GuavTek/beat_sequencer/README.md

A MIDI sequencer for percussion using a RP-PICO, WS2812 LEDs, and cherry style keyboard switches
