GuavTek/beat_sequencer/models/Brackets.FCStd

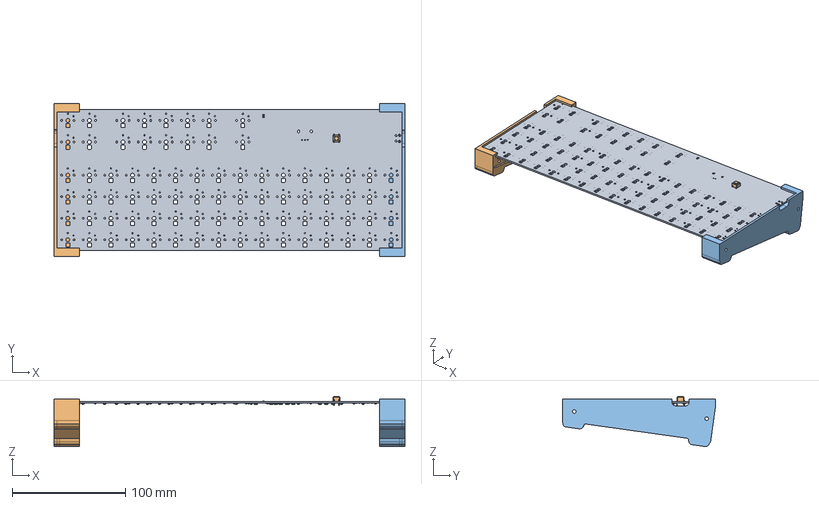
[picture p1: CAD file, 2025-08-24]
models/Brackets.FCStd
309.4 x 134.6 x 44.2 mm
Pcb_fe1a
SW1_SW_PUSH_6mm_1e4c37d32693
R12_R_0603_1608Metric_42a85f441d96
R11_R_0603_1608Metric_2ad46005715d
D87_D_SOD-323_df57b024e58b
C54_C_0603_1608Metric_0bb739a3cacc
D88_D_SOD-323_5da01f37f255
R5_R_0603_1608Metric_38cea7d3a2cd
C58_C_0603_1608Metric_b7960c42b45d
C64_C_0603_1608Metric_9a160810e8e0
C68_C_0603_1608Metric_f0870da7f894
C20_C_0603_1608Metric_39ede622b60a
D93_D_SOD-323_66f03b6b84d4
C74_C_0603_1608Metric_994731c39234
D102_D_SOD-323_32bd23d8ab15
D91_D_SOD-323_a9d0ef1906f3
C62_C_0603_1608Metric_5dbc99736f9b
D126_D_SOD-323_1330ebb01137
D135_D_SOD-323_9d37f7f3c965
C37_C_0603_1608Metric_5208c6173dee
C3_C_0603_1608Metric_93aa2dda32cd
C40_C_0603_1608Metric_ccfb9d428a65
C73_C_0603_1608Metric_03d7558e01c5
D97_D_SOD-323_eaafedaa016f
R14_R_0603_1608Metric_2a0c1422eca9
D145_D_SOD-323_bd2c4b9b8c90
Q1_SOT-23_5640edacd0cb
D120_D_SOD-323_66820572dc02
C52_C_0603_1608Metric_7ae5c74cfe28
C11_C_0603_1608Metric_020c473892fd
C32_C_0603_1608Metric_78320fb544b5
C78_C_0603_1608Metric_072a739cbfb6
C47_C_0603_1608Metric_d000b179ed23
D95_D_SOD-323_79b8c3906511
C43_C_0603_1608Metric_1a32d7d28331
C38_C_0603_1608Metric_9d6507d8d500
D81_D_SOD-323_9596605a0159
D114_D_SOD-323_caa570405683
C9_C_0603_1608Metric_98b8517860d0
C65_C_0603_1608Metric_bca26b5c2557
C60_C_0603_1608Metric_b23a9420f492
D156_D_SOD-323_725008c5ad5e
C44_C_0603_1608Metric_2969dd3a299a
C29_C_0603_1608Metric_ec4414a6af9b
C19_C_0603_1608Metric_21f14bfd3467
Q4_SOT-23_cc986ddf7d09
D105_D_SOD-323_dec81850e9a2
D146_D_SOD-323_f9cb06448b9b
D125_D_SOD-323_48fd01ee04ac
R7_R_0603_1608Metric_6d629bdbb133
C80_C_0603_1608Metric_6dd7261405f1
Q6_SOT-23_9162bb17def2
D132_D_SOD-323_067e024d3ad2
D117_D_SOD-323_39e64060aef6
D106_D_SOD-323_b2b98c925441
D84_D_SOD-323_7ff9f476dcc5
D113_D_SOD-323_2862c8264082
D116_D_SOD-323_dfc335532dbf
C2_C_0603_1608Metric_1f6ee4a5b66e
D134_D_SOD-323_ed6a9de8ff42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
