GuavTek/beat_sequencer/models/Brackets-Left bracket.stl

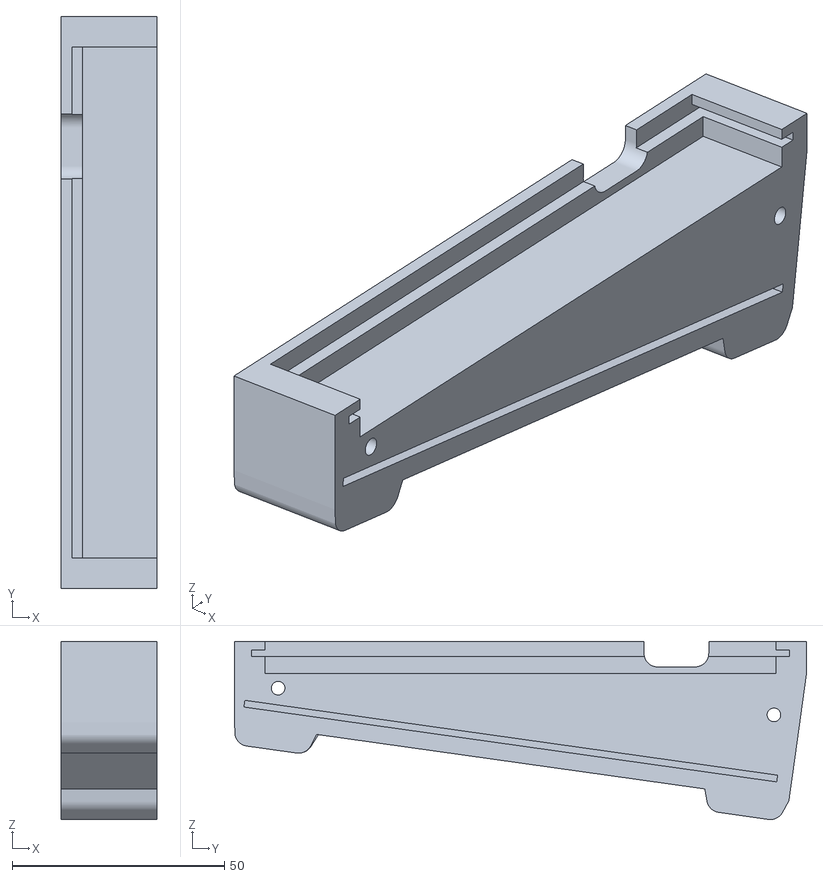
[picture p2: CAD file, 2025-08-24]
models/Brackets-Left bracket.stl
22.5 x 134.6 x 41.9
