GuavTek/beat_sequencer/models/Brackets-Left bracket (mirrored).stl

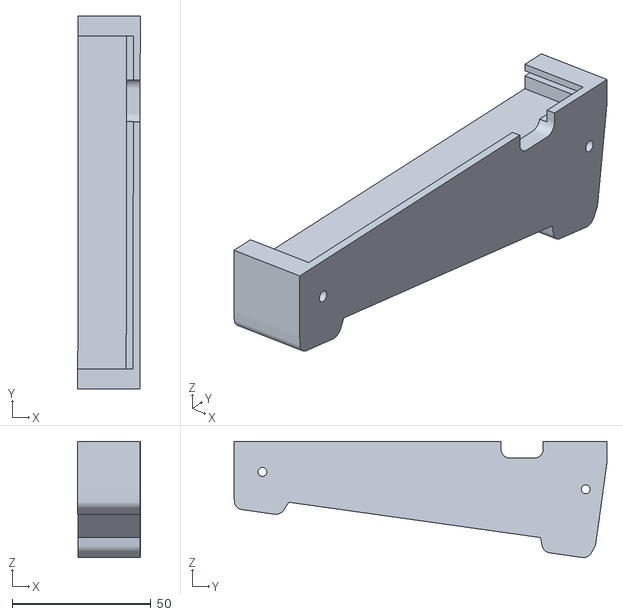
[picture p3: CAD file, 2025-08-24]
models/Brackets-Left bracket (mirrored).stl
22.6 x 134.6 x 41.9
