GuavTek/beat_sequencer/hardware_mx/beat_sequencer.kicad_pcb

## KiCad design hardware_mx/beat_sequencer.kicad_pcb (2025-08-23)

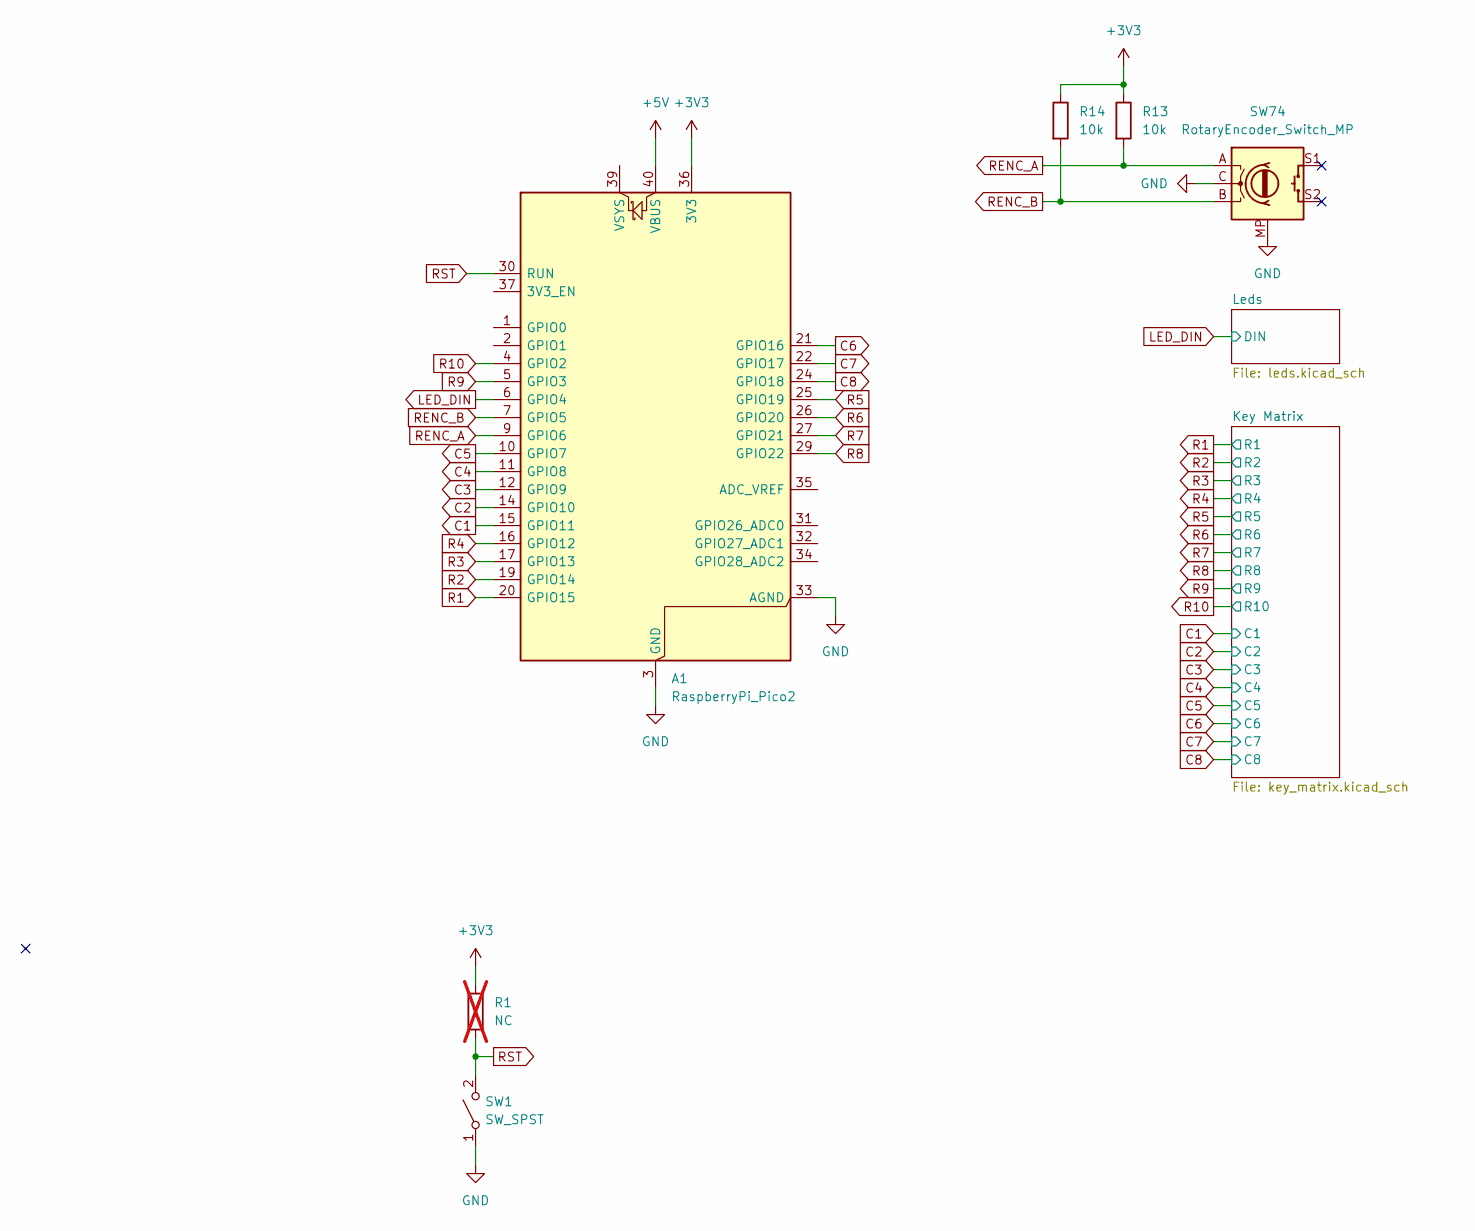
[picture p4: schematic beat_sequencer.kicad_sch]

Parts:
A1: RaspberryPi_Pico2; RaspberryPi_Pico_Common_SMD
R1: NC; R_0603_1608Metric; not fitted
R13, R14: 10k; R_0603_1608Metric
SW1: SW_SPST; SW_PUSH_6mm
SW74: RotaryEncoder_Switch_MP; RotaryEncoder_Alps_EC12E_Vertical_H20mm

Connections:
+3V3: A1.36 (3V3), R1.1, R13.1, R14.1; also elsewhere on the board
+5V: A1.40 (VBUS); also elsewhere on the board
C1: A1.15 (GPIO11); also elsewhere on the board
C2: A1.14 (GPIO10); also elsewhere on the board
C3: A1.12 (GPIO9); also elsewhere on the board
C4: A1.11 (GPIO8); also elsewhere on the board
C5: A1.10 (GPIO7); also elsewhere on the board
C6: A1.21 (GPIO16); also elsewhere on the board
C7: A1.22 (GPIO17); also elsewhere on the board
C8: A1.24 (GPIO18); also elsewhere on the board
GND: A1.3 (GND), A1.8 (GND), A1.13 (GND), A1.18 (GND), A1.23 (GND), A1.28 (GND), A1.33 (AGND), A1.38 (GND), SW1.1 (A), SW74.C, SW74.MP; also elsewhere on the board
LED_DIN: A1.6 (GPIO4); also elsewhere on the board
R1: A1.20 (GPIO15); also elsewhere on the board
R2: A1.19 (GPIO14); also elsewhere on the board
R3: A1.17 (GPIO13); also elsewhere on the board
R4: A1.16 (GPIO12); also elsewhere on the board
R5: A1.25 (GPIO19); also elsewhere on the board
R6: A1.26 (GPIO20); also elsewhere on the board
R7: A1.27 (GPIO21); also elsewhere on the board
R8: A1.29 (GPIO22); also elsewhere on the board
R9: A1.5 (GPIO3); also elsewhere on the board
R10: A1.4 (GPIO2); also elsewhere on the board
RENC_A: A1.9 (GPIO6), R13.2, SW74.A
RENC_B: A1.7 (GPIO5), R14.2, SW74.B
RST: A1.30 (RUN), R1.2, SW1.2 (B)

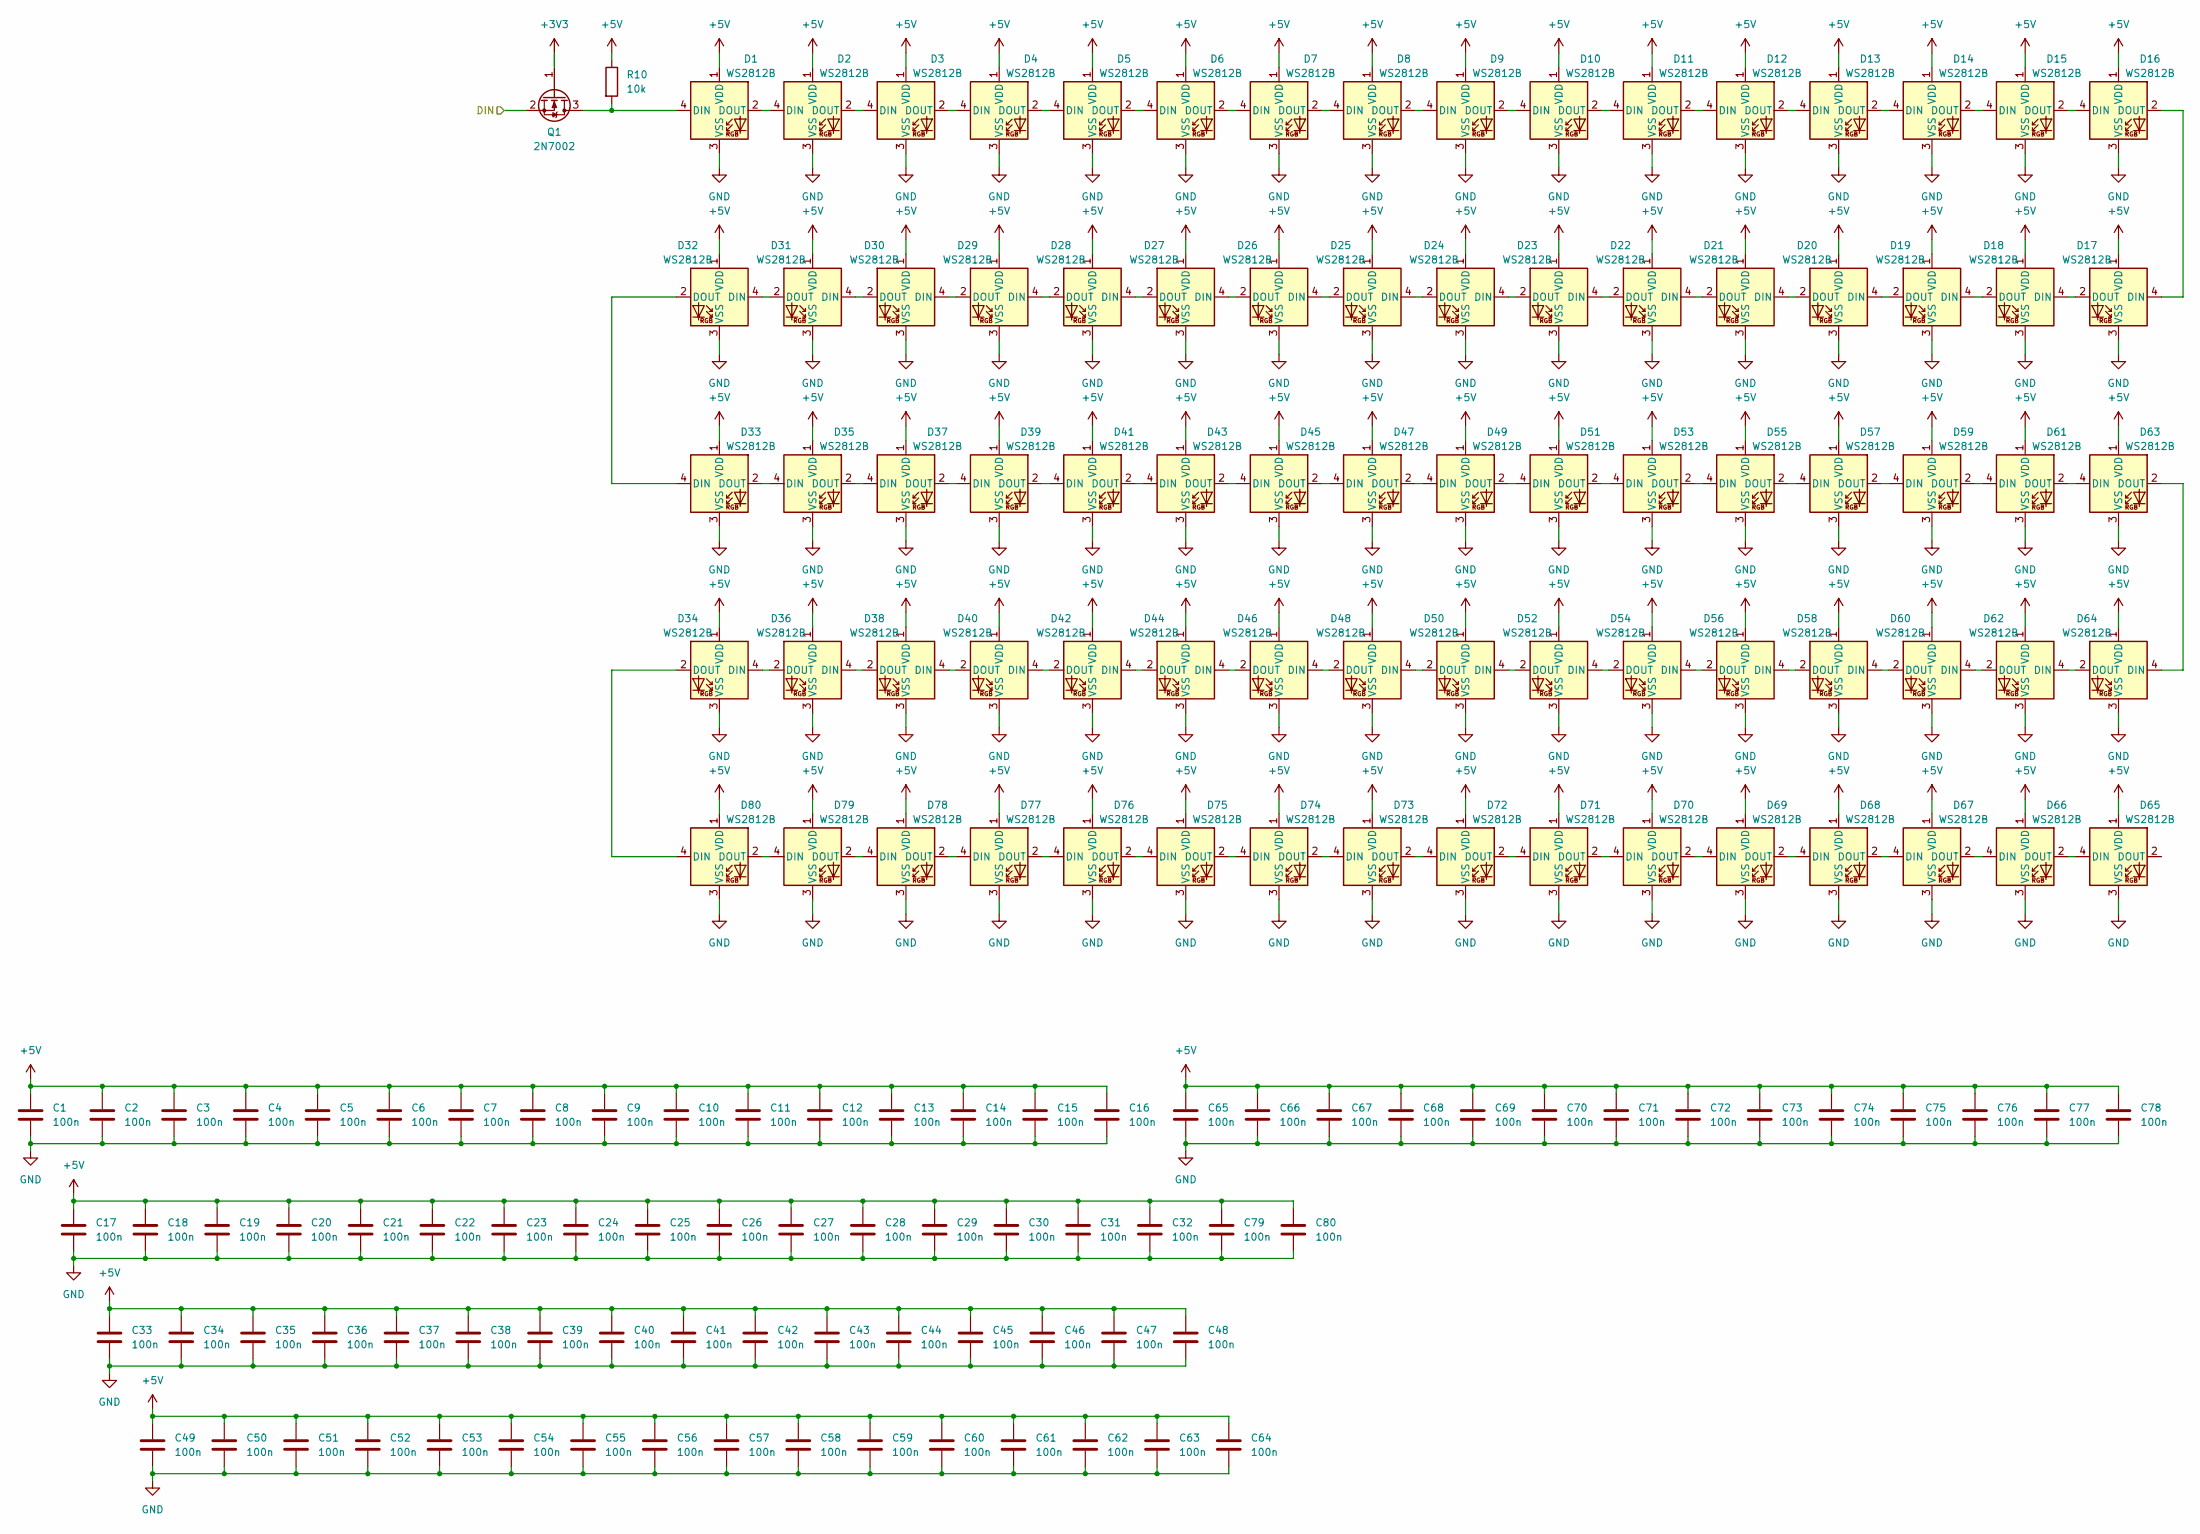
[picture p5: schematic leds.kicad_sch]

Parts:
C1, C2, C3, C4, C5, C6, C7, C8, C9, C10, C11, C12, C13, C14, C15, C16, C17, C18, C19, C20, C21, C22, C23, C24, C25, C26, C27, C28, C29, C30, C31, C32, C33, C34, C35, C36, C37, C38, C39, C40, C41, C42, C43, C44, C45, C46, C47, C48, C49, C50, C51, C52, C53, C54, C55, C56, C57, C58, C59, C60, C61, C62, C63, C64, C65, C66, C67, C68, C69, C70, C71, C72, C73, C74, C75, C76, C77, C78, C79, C80: 100n; C_0603_1608Metric
D1, D2, D3, D4, D5, D6, D7, D8, D9, D10, D11, D12, D13, D14, D15, D16, D17, D18, D19, D20, D21, D22, D23, D24, D25, D26, D27, D28, D29, D30, D31, D32, D33, D34, D35, D36, D37, D38, D39, D40, D41, D42, D43, D44, D45, D46, D47, D48, D49, D50, D51, D52, D53, D54, D55, D56, D57, D58, D59, D60, D61, D62, D63, D64, D65, D66, D67, D68, D69, D70, D71, D72, D73, D74, D75, D76, D77, D78, D79, D80: WS2812B; LED_SK6812_MINI_REVERSE
Q1: 2N7002; SOT-23
R10: 10k; R_0603_1608Metric

Connections:
+3V3: Q1.1 (G); also elsewhere on the board
+5V: C1.1, C2.1, C3.1, C4.1, C5.1, C6.1, C7.1, C8.1, C9.1, C10.1, C11.1, C12.1, C13.1, C14.1, C15.1, C16.1, C17.1, C18.1, C19.1, C20.1, C21.1, C22.1, C23.1, C24.1, C25.1, C26.1, C27.1, C28.1, C29.1, C30.1, C31.1, C32.1, C33.1, C34.1, C35.1, C36.1, C37.1, C38.1, C39.1, C40.1, C41.1, C42.1, C43.1, C44.1, C45.1, C46.1, C47.1, C48.1, C49.1, C50.1, C51.1, C52.1, C53.1, C54.1, C55.1, C56.1, C57.1, C58.1, C59.1, C60.1, C61.1, C62.1, C63.1, C64.1, C65.1, C66.1, C67.1, C68.1, C69.1, C70.1, C71.1, C72.1, C73.1, C74.1, C75.1, C76.1, C77.1, C78.1, C79.1, C80.1, D1.1 (VDD), D2.1 (VDD), D3.1 (VDD), D4.1 (VDD), D5.1 (VDD), D6.1 (VDD), D7.1 (VDD), D8.1 (VDD), D9.1 (VDD), D10.1 (VDD), D11.1 (VDD), D12.1 (VDD), D13.1 (VDD), D14.1 (VDD), D15.1 (VDD), D16.1 (VDD), D17.1 (VDD), D18.1 (VDD), D19.1 (VDD), D20.1 (VDD), D21.1 (VDD), D22.1 (VDD), D23.1 (VDD), D24.1 (VDD), D25.1 (VDD), D26.1 (VDD), D27.1 (VDD), D28.1 (VDD), D29.1 (VDD), D30.1 (VDD), D31.1 (VDD), D32.1 (VDD), D33.1 (VDD), D34.1 (VDD), D35.1 (VDD), D36.1 (VDD), D37.1 (VDD), D38.1 (VDD), D39.1 (VDD), D40.1 (VDD), D41.1 (VDD), D42.1 (VDD), D43.1 (VDD), D44.1 (VDD), D45.1 (VDD), D46.1 (VDD), D47.1 (VDD), D48.1 (VDD), D49.1 (VDD), D50.1 (VDD), D51.1 (VDD), D52.1 (VDD), D53.1 (VDD), D54.1 (VDD), D55.1 (VDD), D56.1 (VDD), D57.1 (VDD), D58.1 (VDD), D59.1 (VDD), D60.1 (VDD), D61.1 (VDD), D62.1 (VDD), D63.1 (VDD), D64.1 (VDD), D65.1 (VDD), D66.1 (VDD), D67.1 (VDD), D68.1 (VDD), D69.1 (VDD), D70.1 (VDD), D71.1 (VDD), D72.1 (VDD), D73.1 (VDD), D74.1 (VDD), D75.1 (VDD), D76.1 (VDD), D77.1 (VDD), D78.1 (VDD), D79.1 (VDD), D80.1 (VDD), R10.1; also elsewhere on the board
GND: C1.2, C2.2, C3.2, C4.2, C5.2, C6.2, C7.2, C8.2, C9.2, C10.2, C11.2, C12.2, C13.2, C14.2, C15.2, C16.2, C17.2, C18.2, C19.2, C20.2, C21.2, C22.2, C23.2, C24.2, C25.2, C26.2, C27.2, C28.2, C29.2, C30.2, C31.2, C32.2, C33.2, C34.2, C35.2, C36.2, C37.2, C38.2, C39.2, C40.2, C41.2, C42.2, C43.2, C44.2, C45.2, C46.2, C47.2, C48.2, C49.2, C50.2, C51.2, C52.2, C53.2, C54.2, C55.2, C56.2, C57.2, C58.2, C59.2, C60.2, C61.2, C62.2, C63.2, C64.2, C65.2, C66.2, C67.2, C68.2, C69.2, C70.2, C71.2, C72.2, C73.2, C74.2, C75.2, C76.2, C77.2, C78.2, C79.2, C80.2, D1.3 (VSS), D2.3 (VSS), D3.3 (VSS), D4.3 (VSS), D5.3 (VSS), D6.3 (VSS), D7.3 (VSS), D8.3 (VSS), D9.3 (VSS), D10.3 (VSS), D11.3 (VSS), D12.3 (VSS), D13.3 (VSS), D14.3 (VSS), D15.3 (VSS), D16.3 (VSS), D17.3 (VSS), D18.3 (VSS), D19.3 (VSS), D20.3 (VSS), D21.3 (VSS), D22.3 (VSS), D23.3 (VSS), D24.3 (VSS), D25.3 (VSS), D26.3 (VSS), D27.3 (VSS), D28.3 (VSS), D29.3 (VSS), D30.3 (VSS), D31.3 (VSS), D32.3 (VSS), D33.3 (VSS), D34.3 (VSS), D35.3 (VSS), D36.3 (VSS), D37.3 (VSS), D38.3 (VSS), D39.3 (VSS), D40.3 (VSS), D41.3 (VSS), D42.3 (VSS), D43.3 (VSS), D44.3 (VSS), D45.3 (VSS), D46.3 (VSS), D47.3 (VSS), D48.3 (VSS), D49.3 (VSS), D50.3 (VSS), D51.3 (VSS), D52.3 (VSS), D53.3 (VSS), D54.3 (VSS), D55.3 (VSS), D56.3 (VSS), D57.3 (VSS), D58.3 (VSS), D59.3 (VSS), D60.3 (VSS), D61.3 (VSS), D62.3 (VSS), D63.3 (VSS), D64.3 (VSS), D65.3 (VSS), D66.3 (VSS), D67.3 (VSS), D68.3 (VSS), D69.3 (VSS), D70.3 (VSS), D71.3 (VSS), D72.3 (VSS), D73.3 (VSS), D74.3 (VSS), D75.3 (VSS), D76.3 (VSS), D77.3 (VSS), D78.3 (VSS), D79.3 (VSS), D80.3 (VSS); also elsewhere on the board
LED_DIN: Q1.2 (S); also elsewhere on the board
unnamed: D1.4 (DIN), Q1.3 (D), R10.2
unnamed: D1.2 (DOUT), D2.4 (DIN)
unnamed: D2.2 (DOUT), D3.4 (DIN)
unnamed: D3.2 (DOUT), D4.4 (DIN)
unnamed: D4.2 (DOUT), D5.4 (DIN)
unnamed: D5.2 (DOUT), D6.4 (DIN)
unnamed: D6.2 (DOUT), D7.4 (DIN)
unnamed: D7.2 (DOUT), D8.4 (DIN)
unnamed: D8.2 (DOUT), D9.4 (DIN)
unnamed: D9.2 (DOUT), D10.4 (DIN)
unnamed: D10.2 (DOUT), D11.4 (DIN)
unnamed: D11.2 (DOUT), D12.4 (DIN)
unnamed: D12.2 (DOUT), D13.4 (DIN)
unnamed: D13.2 (DOUT), D14.4 (DIN)
unnamed: D14.2 (DOUT), D15.4 (DIN)
unnamed: D15.2 (DOUT), D16.4 (DIN)
unnamed: D16.2 (DOUT), D17.4 (DIN)
unnamed: D17.2 (DOUT), D18.4 (DIN)
unnamed: D18.2 (DOUT), D19.4 (DIN)
unnamed: D19.2 (DOUT), D20.4 (DIN)
unnamed: D20.2 (DOUT), D21.4 (DIN)
unnamed: D21.2 (DOUT), D22.4 (DIN)
unnamed: D22.2 (DOUT), D23.4 (DIN)
unnamed: D23.2 (DOUT), D24.4 (DIN)
unnamed: D24.2 (DOUT), D25.4 (DIN)
unnamed: D25.2 (DOUT), D26.4 (DIN)
unnamed: D26.2 (DOUT), D27.4 (DIN)
unnamed: D27.2 (DOUT), D28.4 (DIN)
unnamed: D28.2 (DOUT), D29.4 (DIN)
unnamed: D29.2 (DOUT), D30.4 (DIN)
unnamed: D30.2 (DOUT), D31.4 (DIN)
unnamed: D31.2 (DOUT), D32.4 (DIN)
unnamed: D32.2 (DOUT), D33.4 (DIN)
unnamed: D33.2 (DOUT), D35.4 (DIN)
unnamed: D34.4 (DIN), D36.2 (DOUT)
unnamed: D34.2 (DOUT), D80.4 (DIN)
unnamed: D35.2 (DOUT), D37.4 (DIN)
unnamed: D36.4 (DIN), D38.2 (DOUT)
unnamed: D37.2 (DOUT), D39.4 (DIN)
unnamed: D38.4 (DIN), D40.2 (DOUT)
unnamed: D39.2 (DOUT), D41.4 (DIN)
unnamed: D40.4 (DIN), D42.2 (DOUT)
unnamed: D41.2 (DOUT), D43.4 (DIN)
unnamed: D42.4 (DIN), D44.2 (DOUT)
unnamed: D43.2 (DOUT), D45.4 (DIN)
unnamed: D44.4 (DIN), D46.2 (DOUT)
unnamed: D45.2 (DOUT), D47.4 (DIN)
unnamed: D46.4 (DIN), D48.2 (DOUT)
unnamed: D47.2 (DOUT), D49.4 (DIN)
unnamed: D48.4 (DIN), D50.2 (DOUT)
unnamed: D49.2 (DOUT), D51.4 (DIN)
unnamed: D50.4 (DIN), D52.2 (DOUT)
unnamed: D51.2 (DOUT), D53.4 (DIN)
unnamed: D52.4 (DIN), D54.2 (DOUT)
unnamed: D53.2 (DOUT), D55.4 (DIN)
unnamed: D54.4 (DIN), D56.2 (DOUT)
unnamed: D55.2 (DOUT), D57.4 (DIN)
unnamed: D56.4 (DIN), D58.2 (DOUT)
unnamed: D57.2 (DOUT), D59.4 (DIN)
unnamed: D58.4 (DIN), D60.2 (DOUT)
unnamed: D59.2 (DOUT), D61.4 (DIN)
unnamed: D60.4 (DIN), D62.2 (DOUT)
unnamed: D61.2 (DOUT), D63.4 (DIN)
unnamed: D62.4 (DIN), D64.2 (DOUT)
unnamed: D63.2 (DOUT), D64.4 (DIN)
unnamed: D65.4 (DIN), D66.2 (DOUT)
unnamed: D66.4 (DIN), D67.2 (DOUT)
unnamed: D67.4 (DIN), D68.2 (DOUT)
unnamed: D68.4 (DIN), D69.2 (DOUT)
unnamed: D69.4 (DIN), D70.2 (DOUT)
unnamed: D70.4 (DIN), D71.2 (DOUT)
unnamed: D71.4 (DIN), D72.2 (DOUT)
unnamed: D72.4 (DIN), D73.2 (DOUT)
unnamed: D73.4 (DIN), D74.2 (DOUT)
unnamed: D74.4 (DIN), D75.2 (DOUT)
unnamed: D75.4 (DIN), D76.2 (DOUT)
unnamed: D76.4 (DIN), D77.2 (DOUT)
unnamed: D77.4 (DIN), D78.2 (DOUT)
unnamed: D78.4 (DIN), D79.2 (DOUT)
unnamed: D79.4 (DIN), D80.2 (DOUT)

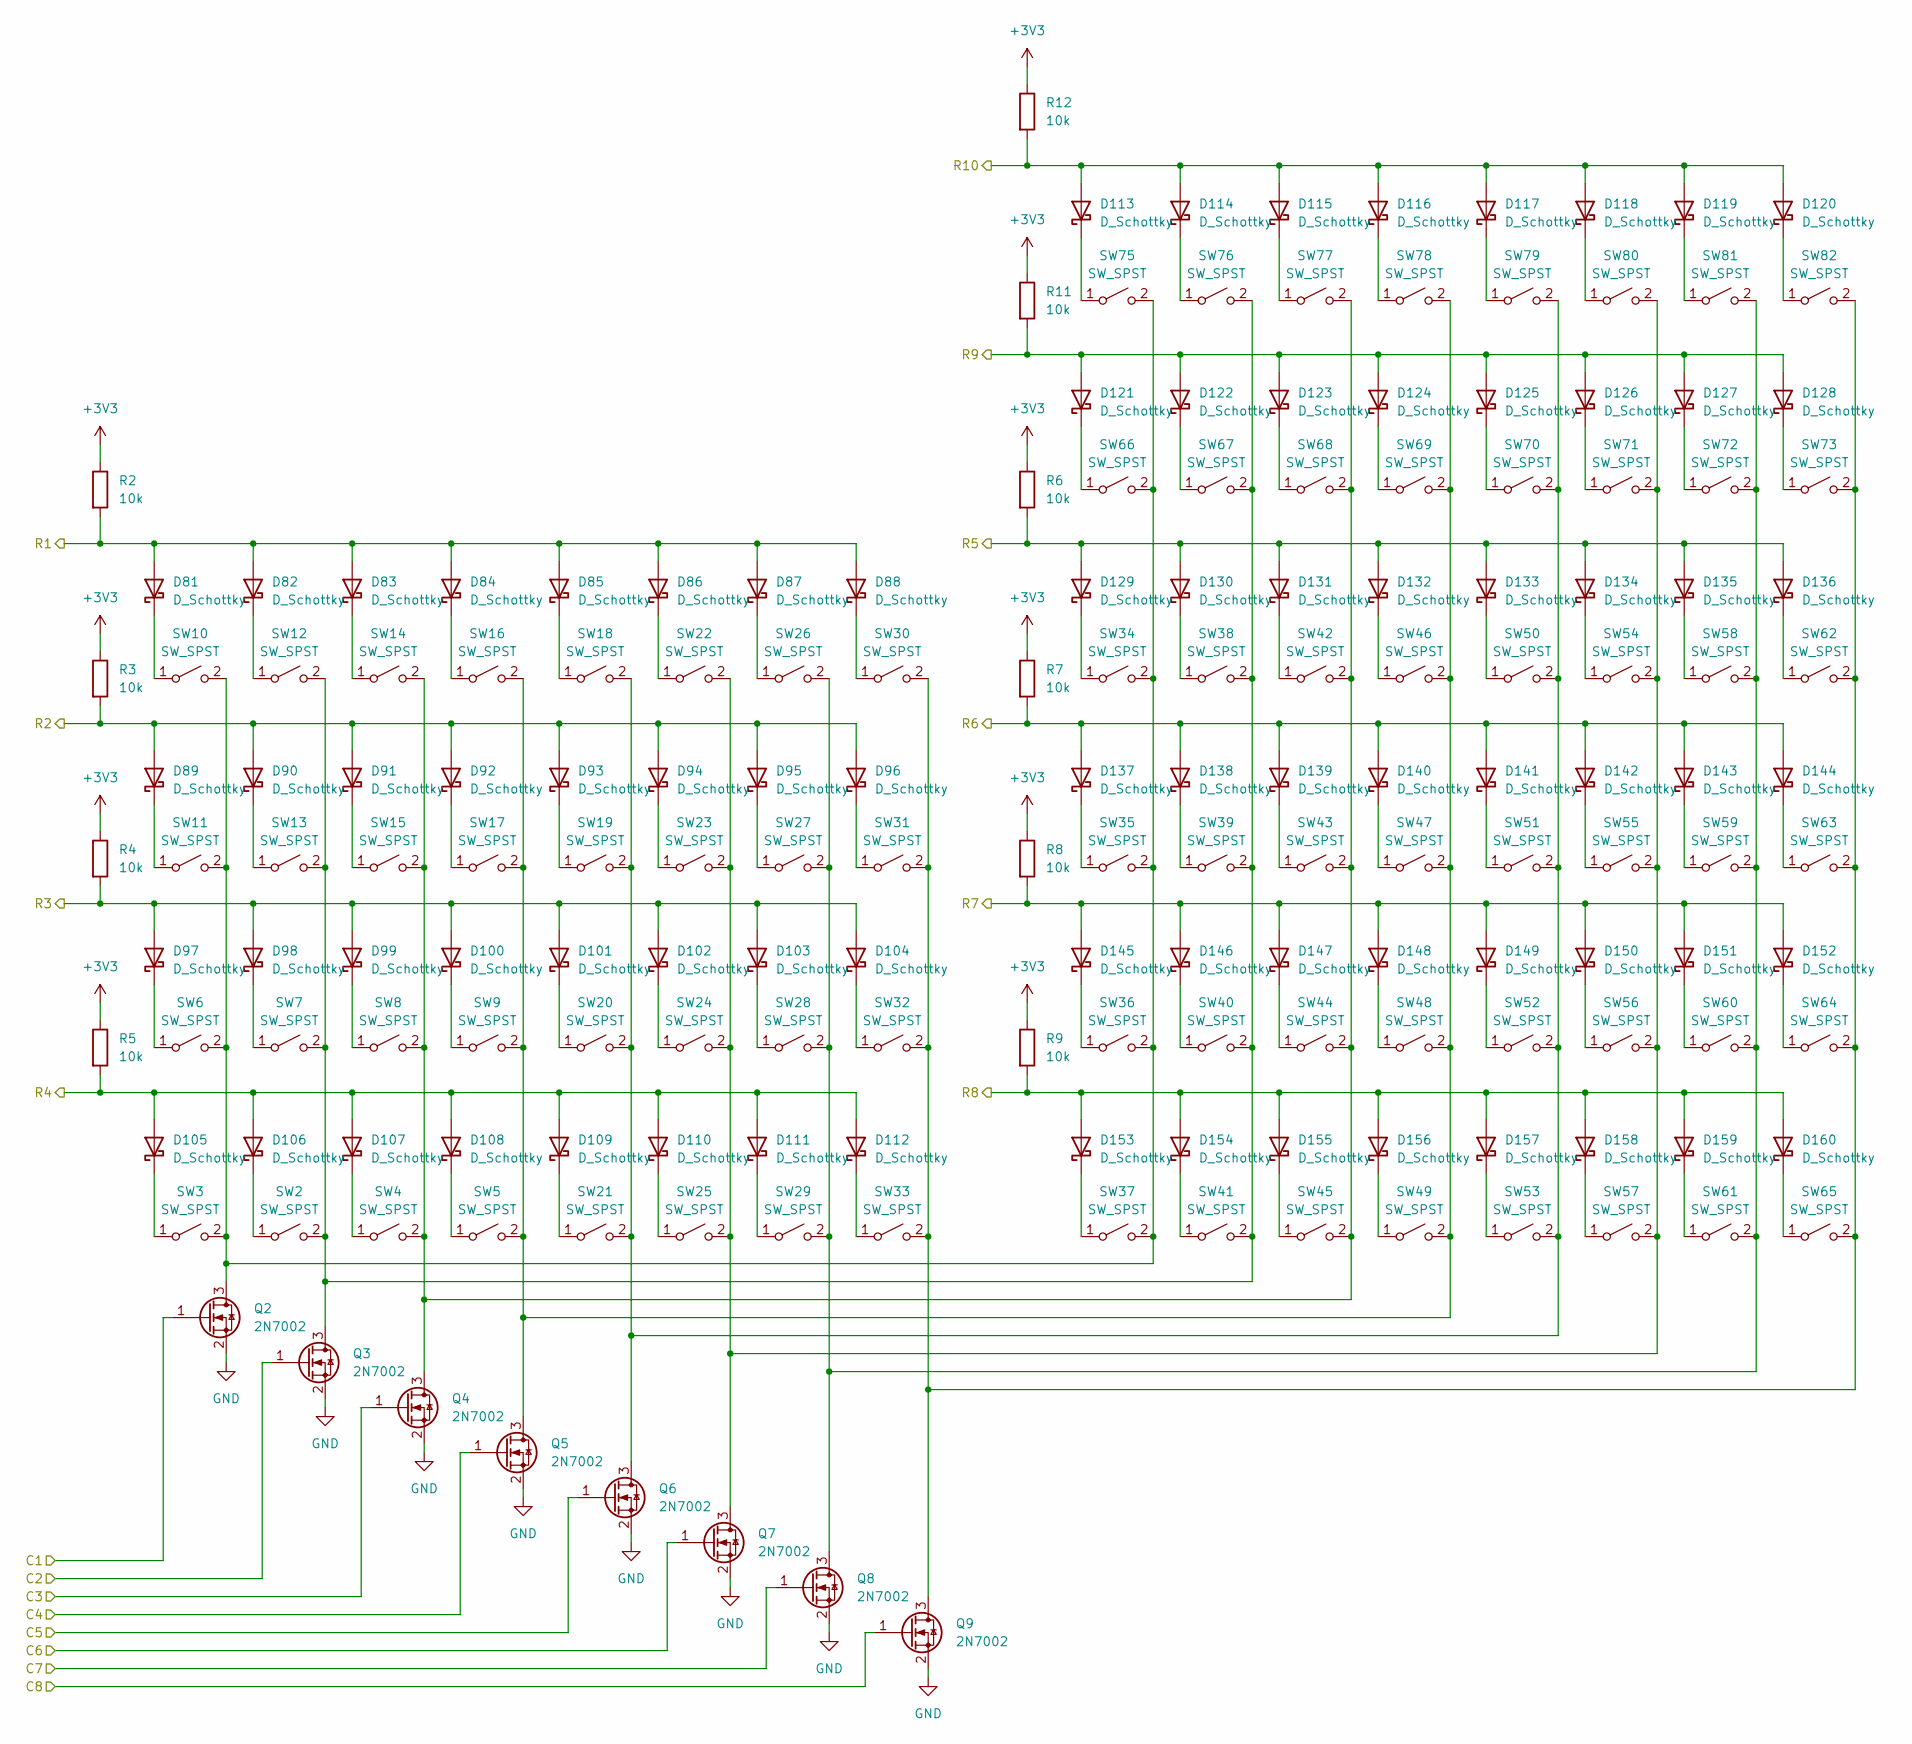
[picture p6: schematic key_matrix.kicad_sch]

Parts:
D81, D82, D83, D84, D85, D86, D87, D88, D89, D90, D91, D92, D93, D94, D95, D96, D97, D98, D99, D100, D101, D102, D103, D104, D105, D106, D107, D108, D109, D110, D111, D112, D113, D114, D115, D116, D117, D118, D119, D120, D121, D122, D123, D124, D125, D126, D127, D128, D129, D130, D131, D132, D133, D134, D135, D136, D137, D138, D139, D140, D141, D142, D143, D144, D145, D146, D147, D148, D149, D150, D151, D152, D153, D154, D155, D156, D157, D158, D159, D160: D_Schottky; D_SOD-323_HandSoldering
Q2, Q3, Q4, Q5, Q6, Q7, Q8, Q9: 2N7002; SOT-23
R2, R3, R4, R5, R6, R7, R8, R9, R11, R12: 10k; R_0603_1608Metric
SW2, SW3, SW4, SW5, SW6, SW7, SW8, SW9, SW10, SW11, SW12, SW13, SW14, SW15, SW16, SW17, SW18, SW19, SW20, SW21, SW22, SW23, SW24, SW25, SW26, SW27, SW28, SW29, SW30, SW31, SW32, SW33, SW34, SW35, SW36, SW37, SW38, SW39, SW40, SW41, SW42, SW43, SW44, SW45, SW46, SW47, SW48, SW49, SW50, SW51, SW52, SW53, SW54, SW55, SW56, SW57, SW58, SW59, SW60, SW61, SW62, SW63, SW64, SW65, SW66, SW67, SW68, SW69, SW70, SW71, SW72, SW73, SW75, SW76, SW77, SW78, SW79, SW80, SW81, SW82: SW_SPST; SW_Cherry_MX_1.00u_PCB

Connections:
+3V3: R2.1, R3.1, R4.1, R5.1, R6.1, R7.1, R8.1, R9.1, R11.1, R12.1; also elsewhere on the board
C1: Q2.1 (G); also elsewhere on the board
C2: Q3.1 (G); also elsewhere on the board
C3: Q4.1 (G); also elsewhere on the board
C4: Q5.1 (G); also elsewhere on the board
C5: Q6.1 (G); also elsewhere on the board
C6: Q7.1 (G); also elsewhere on the board
C7: Q8.1 (G); also elsewhere on the board
C8: Q9.1 (G); also elsewhere on the board
GND: Q2.2 (S), Q3.2 (S), Q4.2 (S), Q5.2 (S), Q6.2 (S), Q7.2 (S), Q8.2 (S), Q9.2 (S); also elsewhere on the board
unnamed: D81.1 (K), SW10.1 (A)
unnamed: D82.1 (K), SW12.1 (A)
unnamed: D83.1 (K), SW14.1 (A)
unnamed: D84.1 (K), SW16.1 (A)
unnamed: D85.1 (K), SW18.1 (A)
unnamed: D86.1 (K), SW22.1 (A)
unnamed: D87.1 (K), SW26.1 (A)
unnamed: D88.1 (K), SW30.1 (A)
unnamed: D89.1 (K), SW11.1 (A)
unnamed: D90.1 (K), SW13.1 (A)
unnamed: D91.1 (K), SW15.1 (A)
unnamed: D92.1 (K), SW17.1 (A)
unnamed: D93.1 (K), SW19.1 (A)
unnamed: D94.1 (K), SW23.1 (A)
unnamed: D95.1 (K), SW27.1 (A)
unnamed: D96.1 (K), SW31.1 (A)
unnamed: D97.1 (K), SW6.1 (A)
unnamed: D98.1 (K), SW7.1 (A)
unnamed: D99.1 (K), SW8.1 (A)
unnamed: D100.1 (K), SW9.1 (A)
unnamed: D101.1 (K), SW20.1 (A)
unnamed: D102.1 (K), SW24.1 (A)
unnamed: D103.1 (K), SW28.1 (A)
unnamed: D104.1 (K), SW32.1 (A)
unnamed: D105.1 (K), SW3.1 (A)
unnamed: D106.1 (K), SW2.1 (A)
unnamed: D107.1 (K), SW4.1 (A)
unnamed: D108.1 (K), SW5.1 (A)
unnamed: D109.1 (K), SW21.1 (A)
unnamed: D110.1 (K), SW25.1 (A)
unnamed: D111.1 (K), SW29.1 (A)
unnamed: D112.1 (K), SW33.1 (A)
unnamed: D113.1 (K), SW75.1 (A)
unnamed: D114.1 (K), SW76.1 (A)
unnamed: D115.1 (K), SW77.1 (A)
unnamed: D116.1 (K), SW78.1 (A)
unnamed: D117.1 (K), SW79.1 (A)
unnamed: D118.1 (K), SW80.1 (A)
unnamed: D119.1 (K), SW81.1 (A)
unnamed: D120.1 (K), SW82.1 (A)
unnamed: D121.1 (K), SW66.1 (A)
unnamed: D122.1 (K), SW67.1 (A)
unnamed: D123.1 (K), SW68.1 (A)
unnamed: D124.1 (K), SW69.1 (A)
unnamed: D125.1 (K), SW70.1 (A)
unnamed: D126.1 (K), SW71.1 (A)
unnamed: D127.1 (K), SW72.1 (A)
unnamed: D128.1 (K), SW73.1 (A)
unnamed: D129.1 (K), SW34.1 (A)
unnamed: D130.1 (K), SW38.1 (A)
unnamed: D131.1 (K), SW42.1 (A)
unnamed: D132.1 (K), SW46.1 (A)
unnamed: D133.1 (K), SW50.1 (A)
unnamed: D134.1 (K), SW54.1 (A)
unnamed: D135.1 (K), SW58.1 (A)
unnamed: D136.1 (K), SW62.1 (A)
unnamed: D137.1 (K), SW35.1 (A)
unnamed: D138.1 (K), SW39.1 (A)
unnamed: D139.1 (K), SW43.1 (A)
unnamed: D140.1 (K), SW47.1 (A)
unnamed: D141.1 (K), SW51.1 (A)
unnamed: D142.1 (K), SW55.1 (A)
unnamed: D143.1 (K), SW59.1 (A)
unnamed: D144.1 (K), SW63.1 (A)
unnamed: D145.1 (K), SW36.1 (A)
unnamed: D146.1 (K), SW40.1 (A)
unnamed: D147.1 (K), SW44.1 (A)
unnamed: D148.1 (K), SW48.1 (A)
unnamed: D149.1 (K), SW52.1 (A)
unnamed: D150.1 (K), SW56.1 (A)
unnamed: D151.1 (K), SW60.1 (A)
unnamed: D152.1 (K), SW64.1 (A)
unnamed: D153.1 (K), SW37.1 (A)
unnamed: D154.1 (K), SW41.1 (A)
unnamed: D155.1 (K), SW45.1 (A)
unnamed: D156.1 (K), SW49.1 (A)
unnamed: D157.1 (K), SW53.1 (A)
unnamed: D158.1 (K), SW57.1 (A)
unnamed: D159.1 (K), SW61.1 (A)
unnamed: D160.1 (K), SW65.1 (A)
unnamed: Q2.3 (D), SW3.2 (B), SW6.2 (B), SW10.2 (B), SW11.2 (B), SW34.2 (B), SW35.2 (B), SW36.2 (B), SW37.2 (B), SW66.2 (B), SW75.2 (B)
unnamed: Q3.3 (D), SW2.2 (B), SW7.2 (B), SW12.2 (B), SW13.2 (B), SW38.2 (B), SW39.2 (B), SW40.2 (B), SW41.2 (B), SW67.2 (B), SW76.2 (B)
unnamed: Q4.3 (D), SW4.2 (B), SW8.2 (B), SW14.2 (B), SW15.2 (B), SW42.2 (B), SW43.2 (B), SW44.2 (B), SW45.2 (B), SW68.2 (B), SW77.2 (B)
unnamed: Q5.3 (D), SW5.2 (B), SW9.2 (B), SW16.2 (B), SW17.2 (B), SW46.2 (B), SW47.2 (B), SW48.2 (B), SW49.2 (B), SW69.2 (B), SW78.2 (B)
unnamed: Q6.3 (D), SW18.2 (B), SW19.2 (B), SW20.2 (B), SW21.2 (B), SW50.2 (B), SW51.2 (B), SW52.2 (B), SW53.2 (B), SW70.2 (B), SW79.2 (B)
unnamed: Q7.3 (D), SW22.2 (B), SW23.2 (B), SW24.2 (B), SW25.2 (B), SW54.2 (B), SW55.2 (B), SW56.2 (B), SW57.2 (B), SW71.2 (B), SW80.2 (B)
unnamed: Q8.3 (D), SW26.2 (B), SW27.2 (B), SW28.2 (B), SW29.2 (B), SW58.2 (B), SW59.2 (B), SW60.2 (B), SW61.2 (B), SW72.2 (B), SW81.2 (B)
unnamed: Q9.3 (D), SW30.2 (B), SW31.2 (B), SW32.2 (B), SW33.2 (B), SW62.2 (B), SW63.2 (B), SW64.2 (B), SW65.2 (B), SW73.2 (B), SW82.2 (B)
R1: D81.2 (A), D82.2 (A), D83.2 (A), D84.2 (A), D85.2 (A), D86.2 (A), D87.2 (A), D88.2 (A), R2.2; also elsewhere on the board
R2: D89.2 (A), D90.2 (A), D91.2 (A), D92.2 (A), D93.2 (A), D94.2 (A), D95.2 (A), D96.2 (A), R3.2; also elsewhere on the board
R3: D97.2 (A), D98.2 (A), D99.2 (A), D100.2 (A), D101.2 (A), D102.2 (A), D103.2 (A), D104.2 (A), R4.2; also elsewhere on the board
R4: D105.2 (A), D106.2 (A), D107.2 (A), D108.2 (A), D109.2 (A), D110.2 (A), D111.2 (A), D112.2 (A), R5.2; also elsewhere on the board
R5: D129.2 (A), D130.2 (A), D131.2 (A), D132.2 (A), D133.2 (A), D134.2 (A), D135.2 (A), D136.2 (A), R6.2; also elsewhere on the board
R6: D137.2 (A), D138.2 (A), D139.2 (A), D140.2 (A), D141.2 (A), D142.2 (A), D143.2 (A), D144.2 (A), R7.2; also elsewhere on the board
R7: D145.2 (A), D146.2 (A), D147.2 (A), D148.2 (A), D149.2 (A), D150.2 (A), D151.2 (A), D152.2 (A), R8.2; also elsewhere on the board
R8: D153.2 (A), D154.2 (A), D155.2 (A), D156.2 (A), D157.2 (A), D158.2 (A), D159.2 (A), D160.2 (A), R9.2; also elsewhere on the board
R9: D121.2 (A), D122.2 (A), D123.2 (A), D124.2 (A), D125.2 (A), D126.2 (A), D127.2 (A), D128.2 (A), R11.2; also elsewhere on the board
R10: D113.2 (A), D114.2 (A), D115.2 (A), D116.2 (A), D117.2 (A), D118.2 (A), D119.2 (A), D120.2 (A), R12.2; also elsewhere on the board

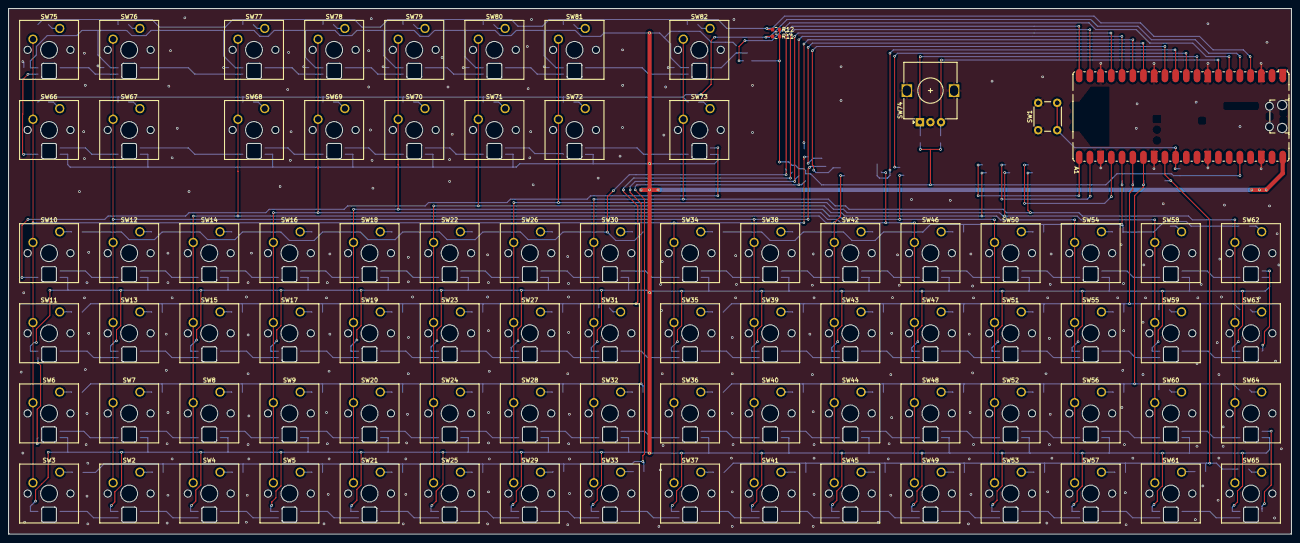
[picture p7: board beat_sequencer.kicad_pcb from above]

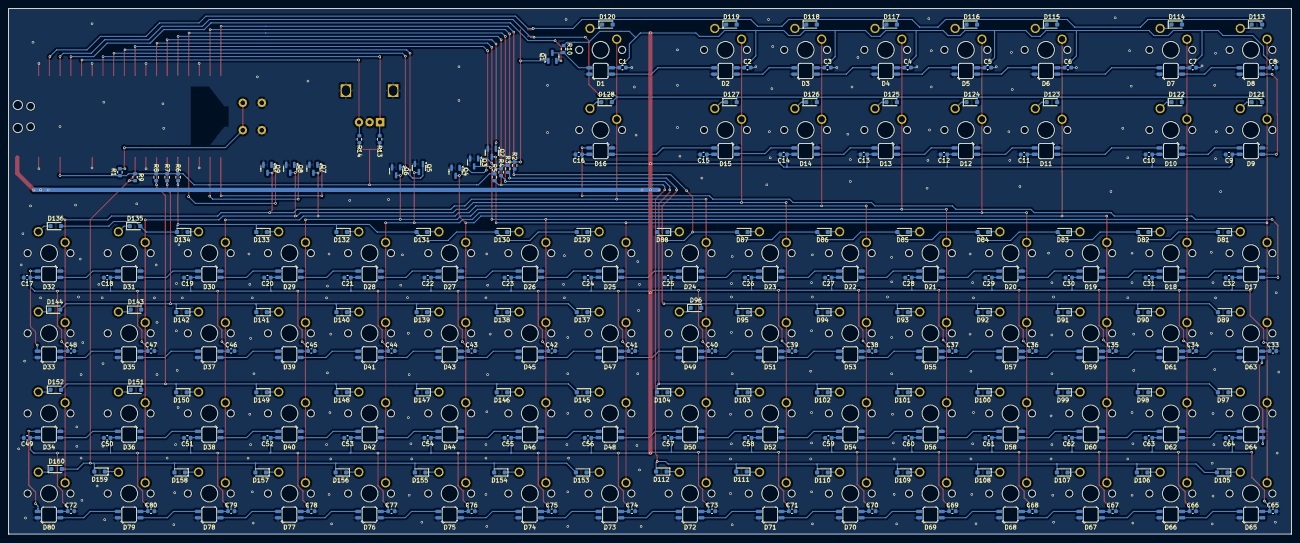
[picture p8: board beat_sequencer.kicad_pcb from below]

Board: 2 copper layers, 304.2 x 124.6 mm, 346 parts (261 on the bottom side), 193 nets.
