GuavTek/beat_sequencer/code/src/pins.h

#ifndef PINS_H_
#define PINS_H_

#define PM_R1 15
#define PM_R2 14
#define PM_R3 13
#define PM_R4 12
#define PM_R5 19
#define PM_R6 20
#define PM_R7 21
#define PM_R8 22
#define PM_R9 3
#define PM_R10 2
#define PM_C1 11
#define PM_C2 10
#define PM_C3 9
#define PM_C4 8
#define PM_C5 7
#define PM_C6 16
#define PM_C7 17
#define PM_C8 18
#define PIXEL 4
#define RENC_A 6
#define RENC_B 5

#endif
