GuavTek/beat_sequencer/(commit log)

2025-06-13 Add initial PCB
    [beat_sequencer.kicad_pcb, beat_sequencer.kicad_sch, key_matrix.kicad_sch, leds.kicad_sch]
2025-07-08 Implement functions for led array
2025-07-11 Read button states
2025-07-11 Add diodes to schematic to prevent ghosting
    [key_matrix.kicad_sch]
2025-07-11 Read rotary encoder
2025-07-11 Move rotary encoder handling to buttons.c
2025-07-12 Fix rotary encoder direction
    [buttons.c]
2025-07-13 Implement velocity multiplier to rotary encoder
2025-07-24 Rename hardware folder to specify switches
    [beat_sequencer.kicad_sch, key_matrix.kicad_sch, leds.kicad_sch]
2025-07-24 Add hardware with choc switches
    [beat_sequencer_choc.kicad_sch, key_matrix.kicad_sch, leds.kicad_sch]
2025-08-23 Add mosfets to columns
    [beat_sequencer.kicad_pcb, beat_sequencer.kicad_sch, key_matrix.kicad_sch]
2025-08-23 Update pico partnumber
    [beat_sequencer_choc.kicad_sch]
2025-08-23 Implement using MOSFETs on columns
2025-08-23 Add brackets model
    [Brackets-Left bracket (mirrored).stl, Brackets-Left bracket.stl, Brackets.FCStd]
2025-08-24 Add some tolerance to the slots
    [Brackets-Left bracket (mirrored).stl, Brackets-Left bracket.stl, Brackets.FCStd]
2025-09-22 Add step velocity
2026-02-24 Fix velocity presets overflowing
    [main.c]
2026-02-24 Fix sequencer freezing due to USB overflow
    [main.c]
